EZdenki/nrf-repeater/nrf-base-bb.jpg

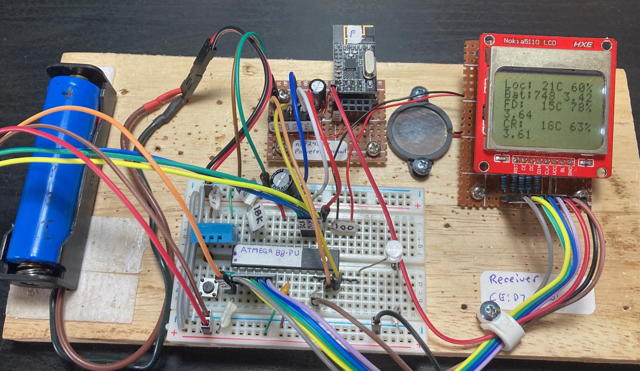
nrf-base-bb.jpg
