EZdenki/nrf-repeater/nrf-remote-sensor-a.jpg

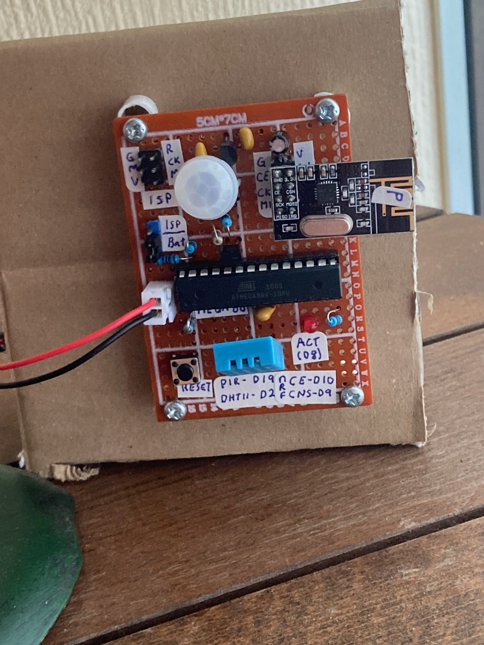
nrf-remote-sensor-a.jpg
