EZdenki/nrf-repeater/LCD-text-grid.docx

Lo 24C 58% B

CR 25C 51% *

FD 32C 28% 3

G1 22C 50% B

G2 28C 28%

R* CR1 FD1

Lo 3.45 V

CR 4.02 V 3

FD 2.08 V B

R* 3.54 V

Lo=Local

CR=Classroom

FD=Fr.Door

G1=Garden 1

G2=Garden 2
