EZdenki/nrf-repeater/moisture-sensor-voltage-follower.png

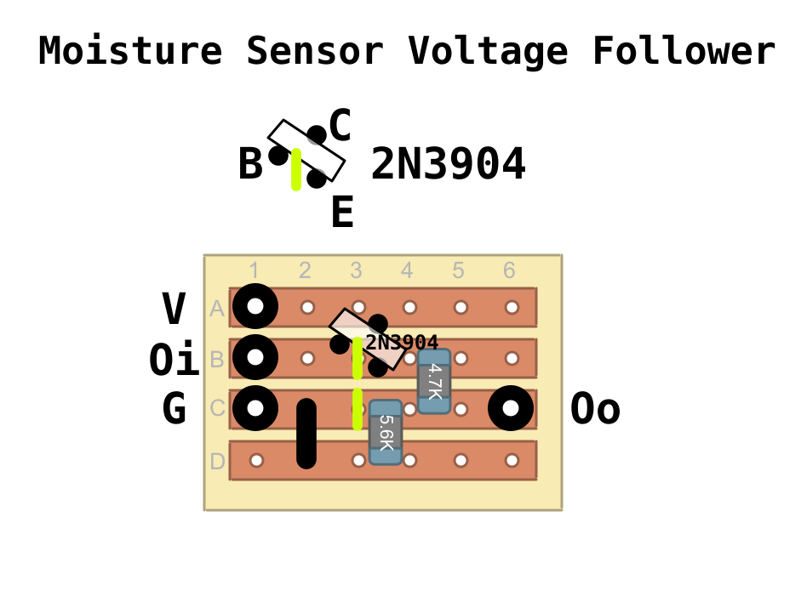
moisture-sensor-voltage-follower.png
