EZdenki/nrf-repeater/narf-remote-sensor-in-situ.jpg

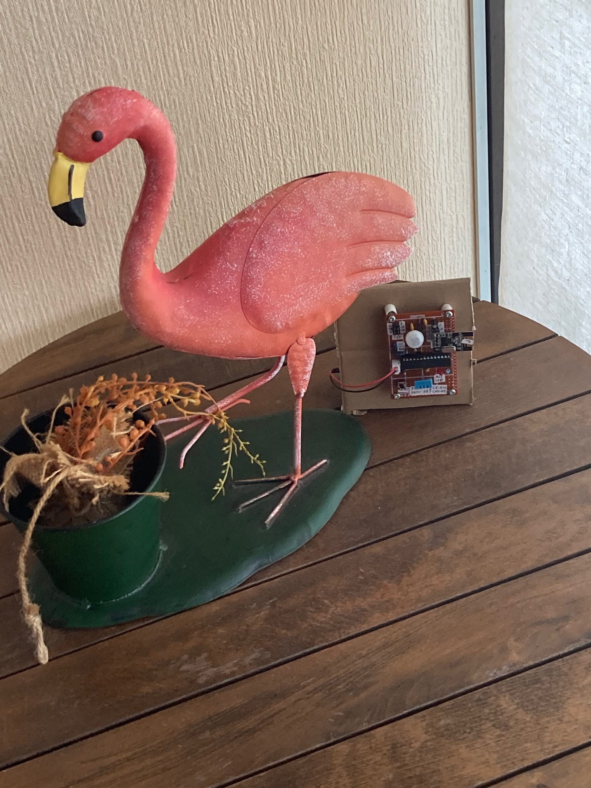
narf-remote-sensor-in-situ.jpg
