EZdenki/nrf-repeater/nrf-moisture-sensor-xmt-v1.1.png

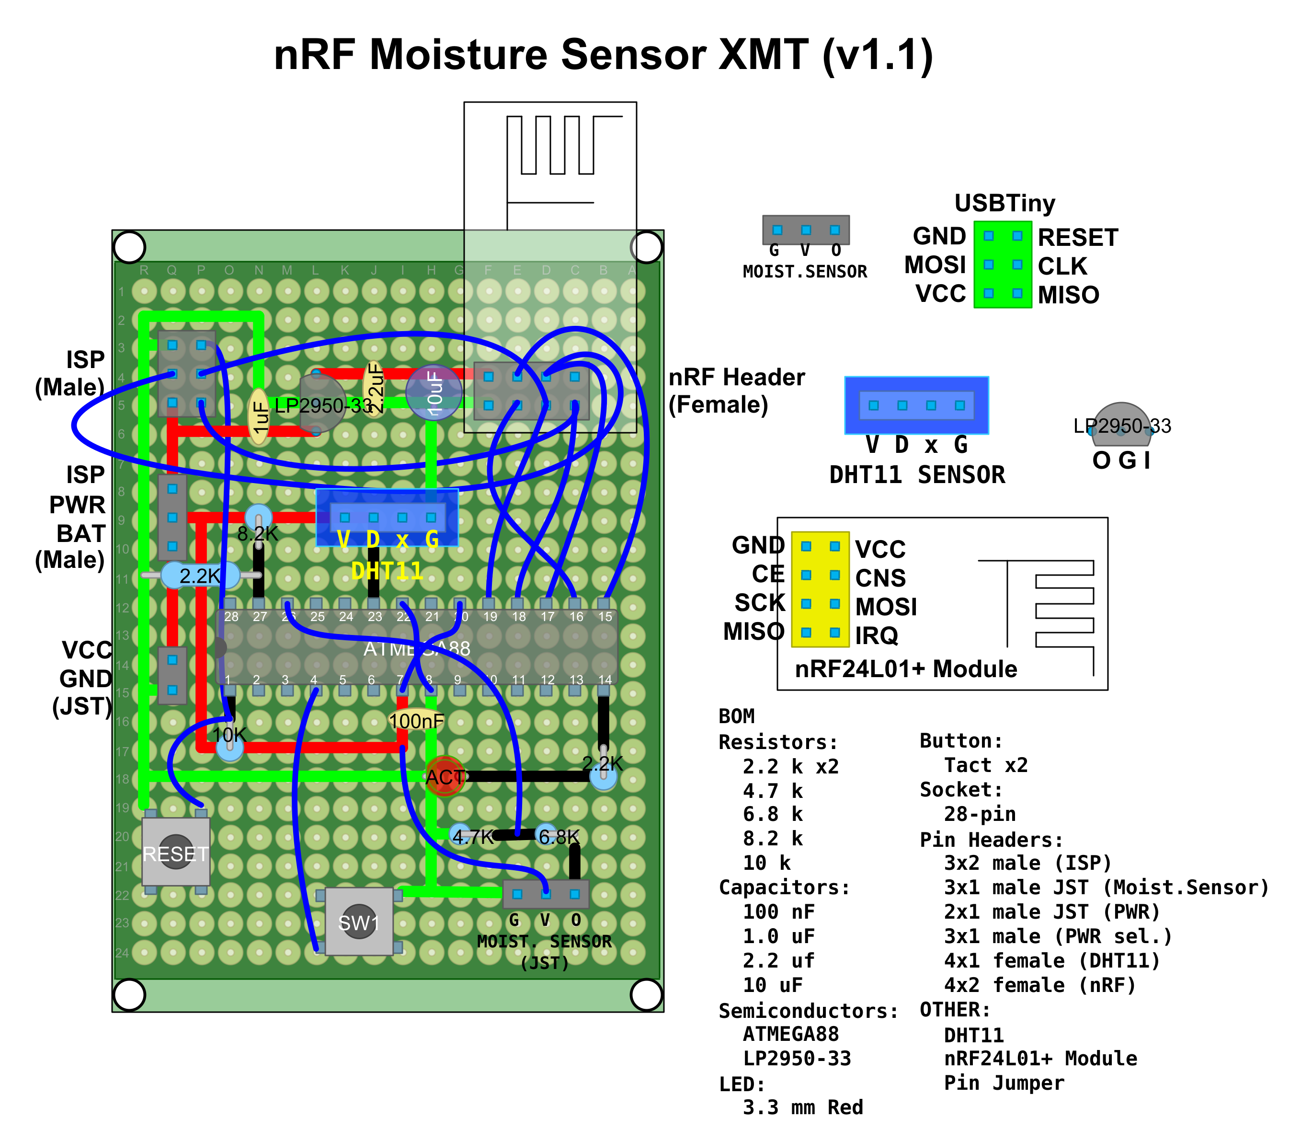
nrf-moisture-sensor-xmt-v1.1.png
