EZdenki/nrf-repeater/nrf-PIR-sensor-xmt-v1.3.png

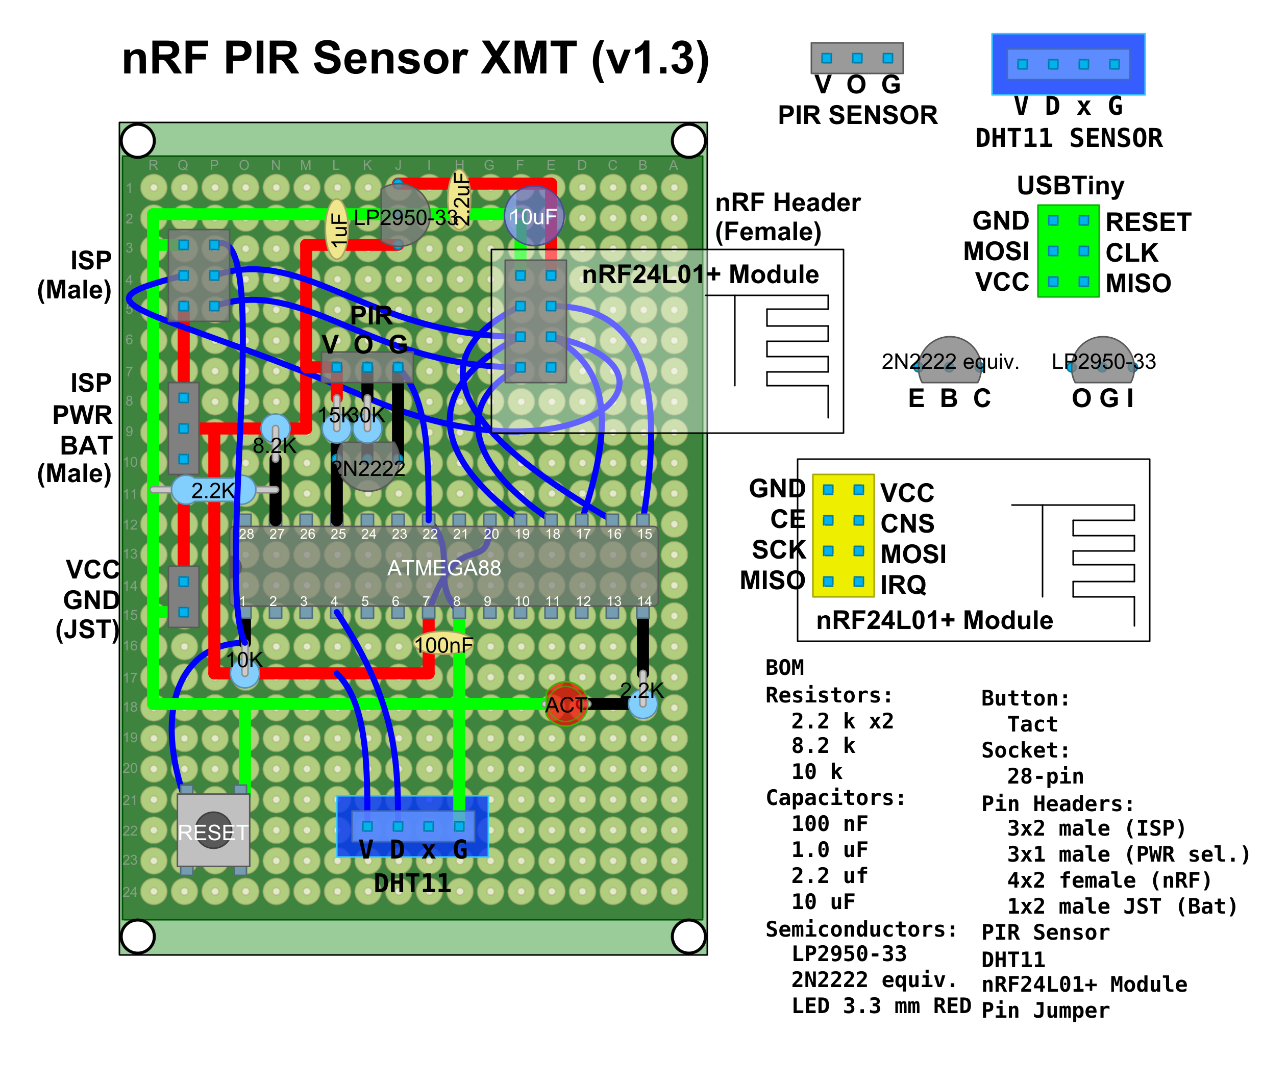
nrf-PIR-sensor-xmt-v1.3.png
