EZdenki/nrf-repeater/nrf-receiver-v1.1.png

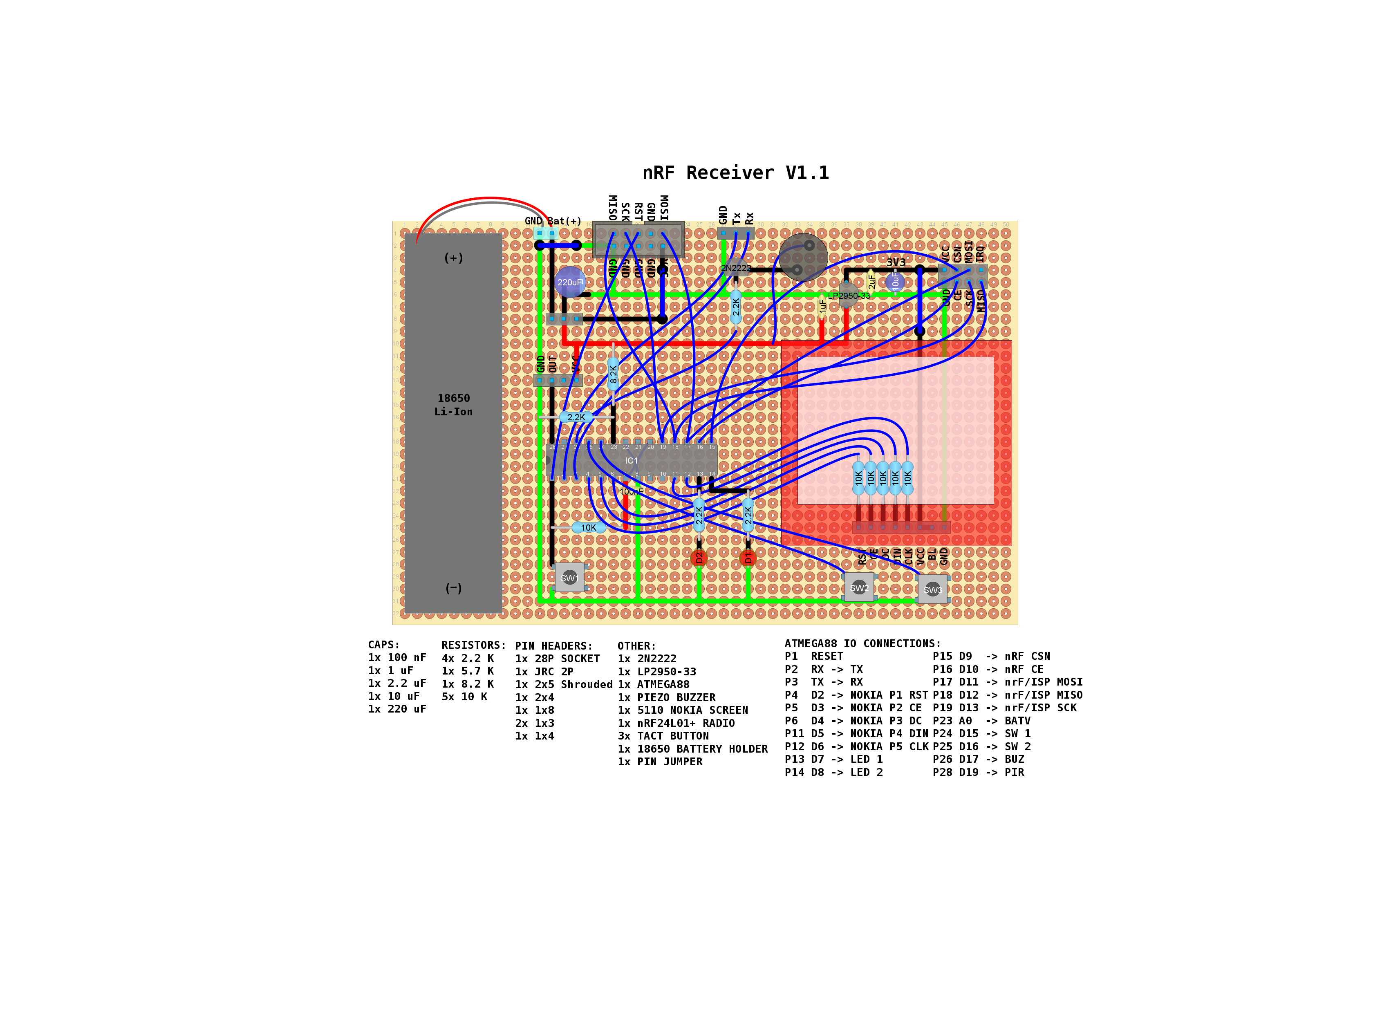
nrf-receiver-v1.1.png
