EZdenki/nrf-repeater/nrf-receiver-v1.2.png

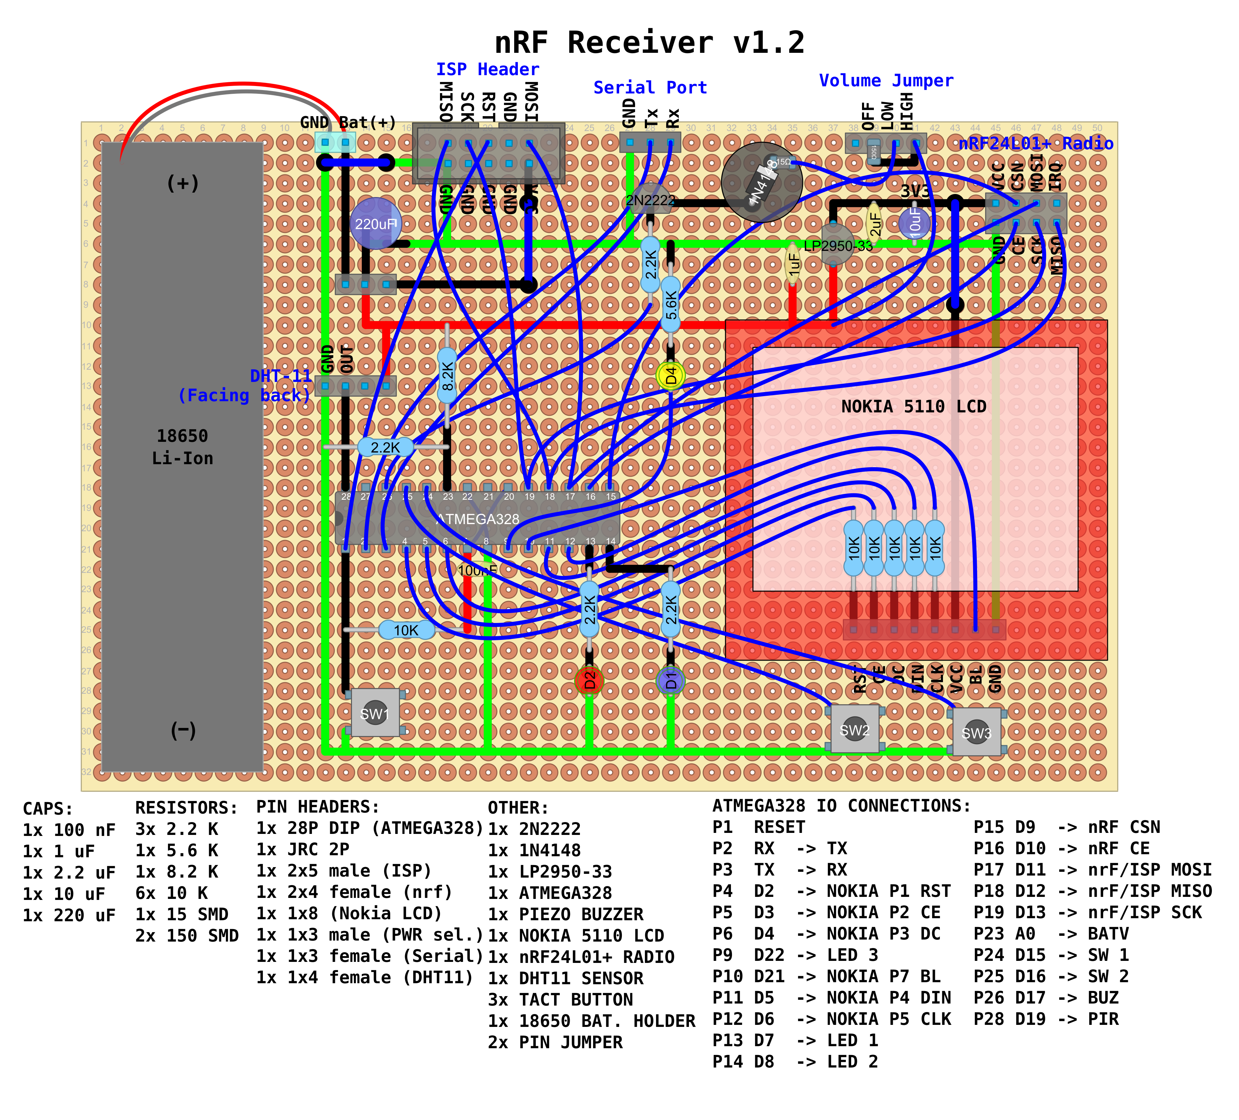
nrf-receiver-v1.2.png
