EZdenki/nrf-repeater/nrf-repeater-v1.1.png

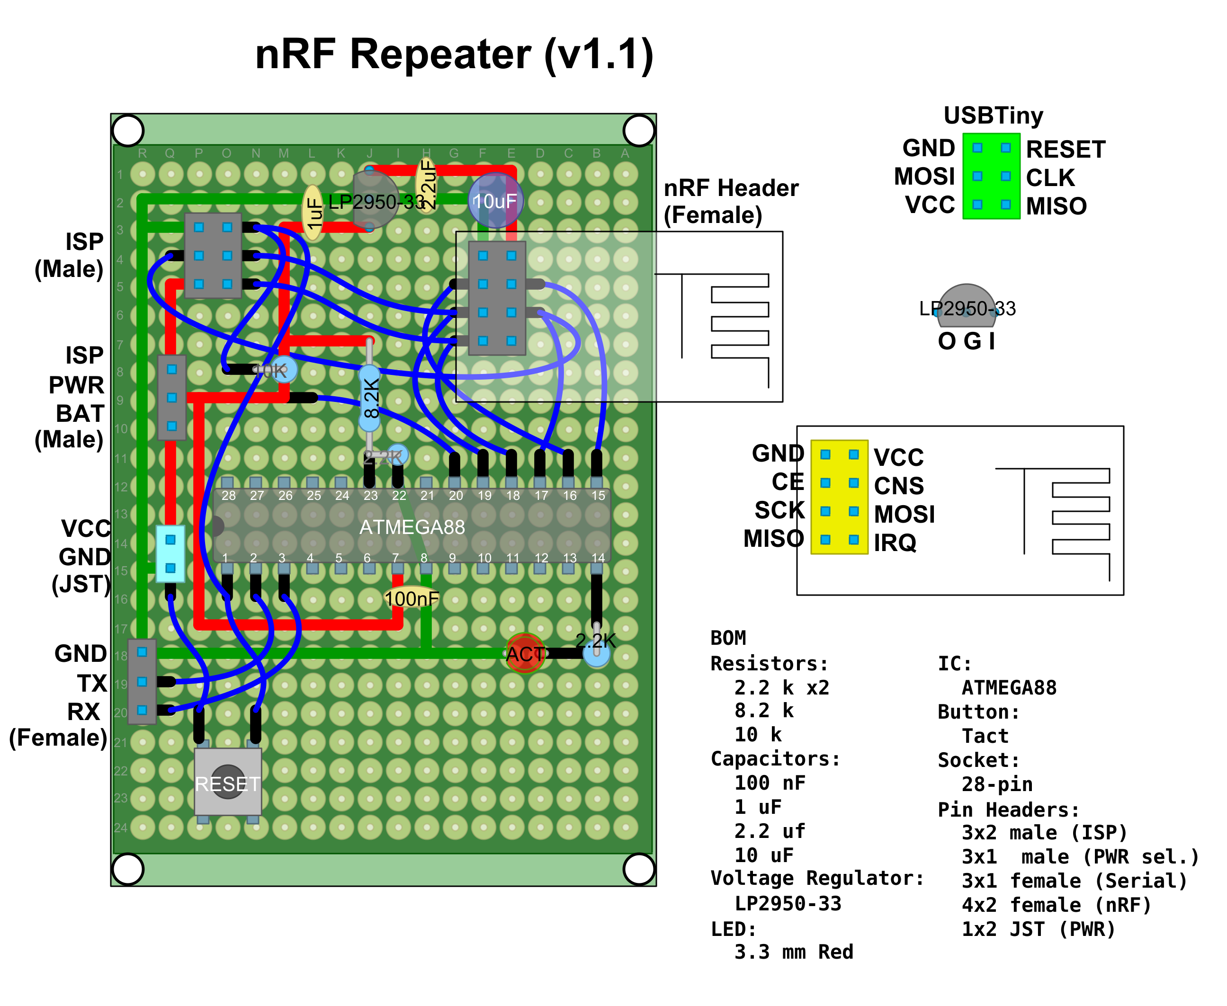
nrf-repeater-v1.1.png
