EZdenki/nrf-repeater/nrf-repeater.jpg

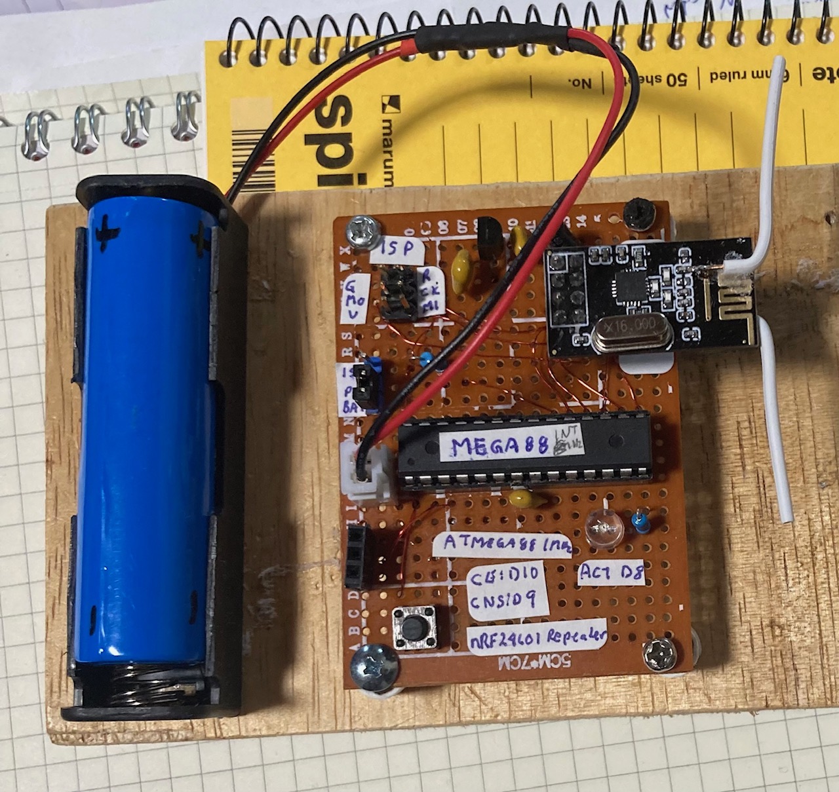
nrf-repeater.jpg
