EZdenki/nrf-repeater/Pics/nRF-Receiver-2.1-pic.jpg

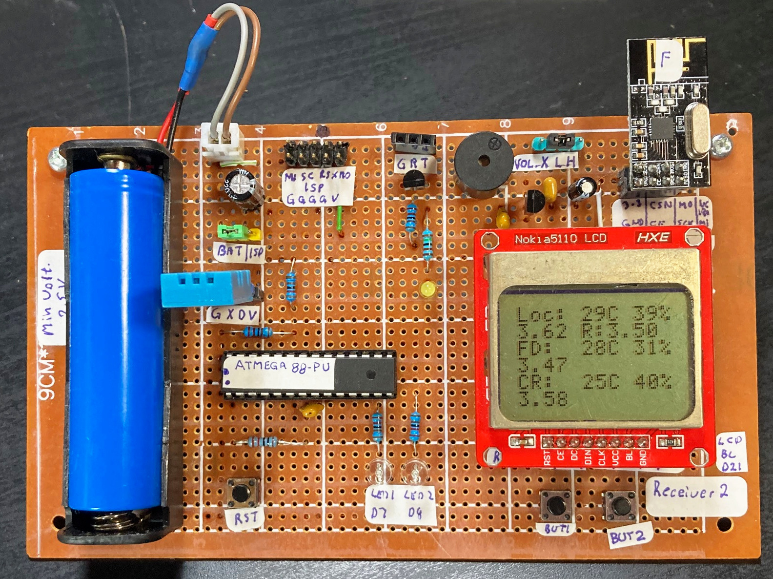
Pics/nRF-Receiver-2.1-pic.jpg
