EZdenki/nrf-repeater/sump/nrf-moisture-sensor-xmt-v0.9.png

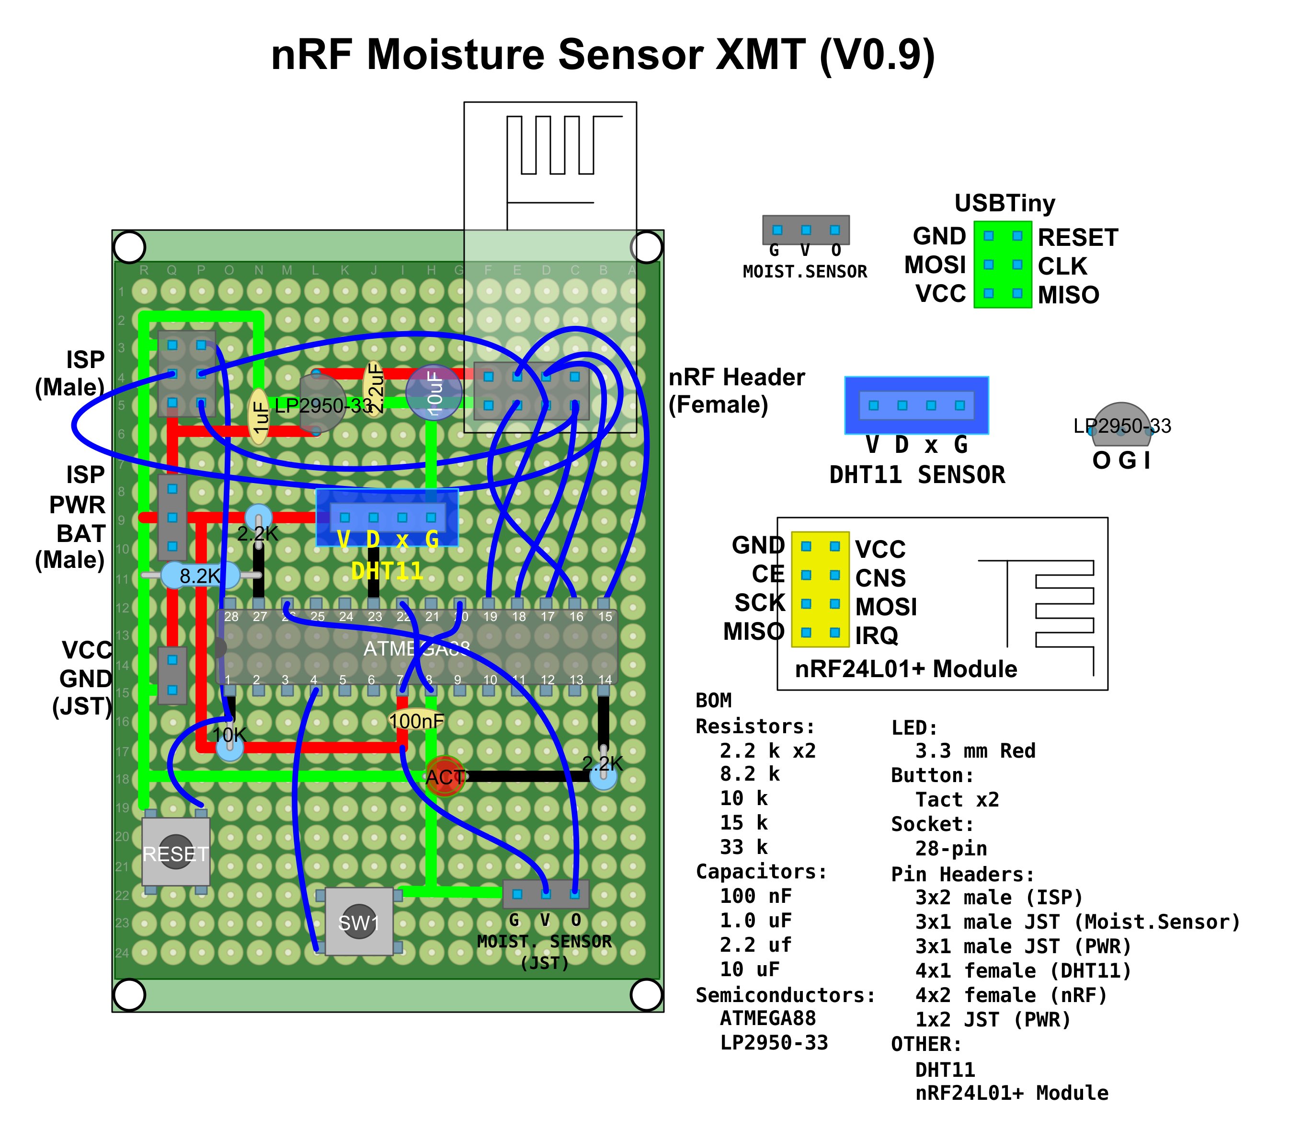
sump/nrf-moisture-sensor-xmt-v0.9.png
