EZdenki/nrf-repeater/sump/nrf-repeater-v1.3.png

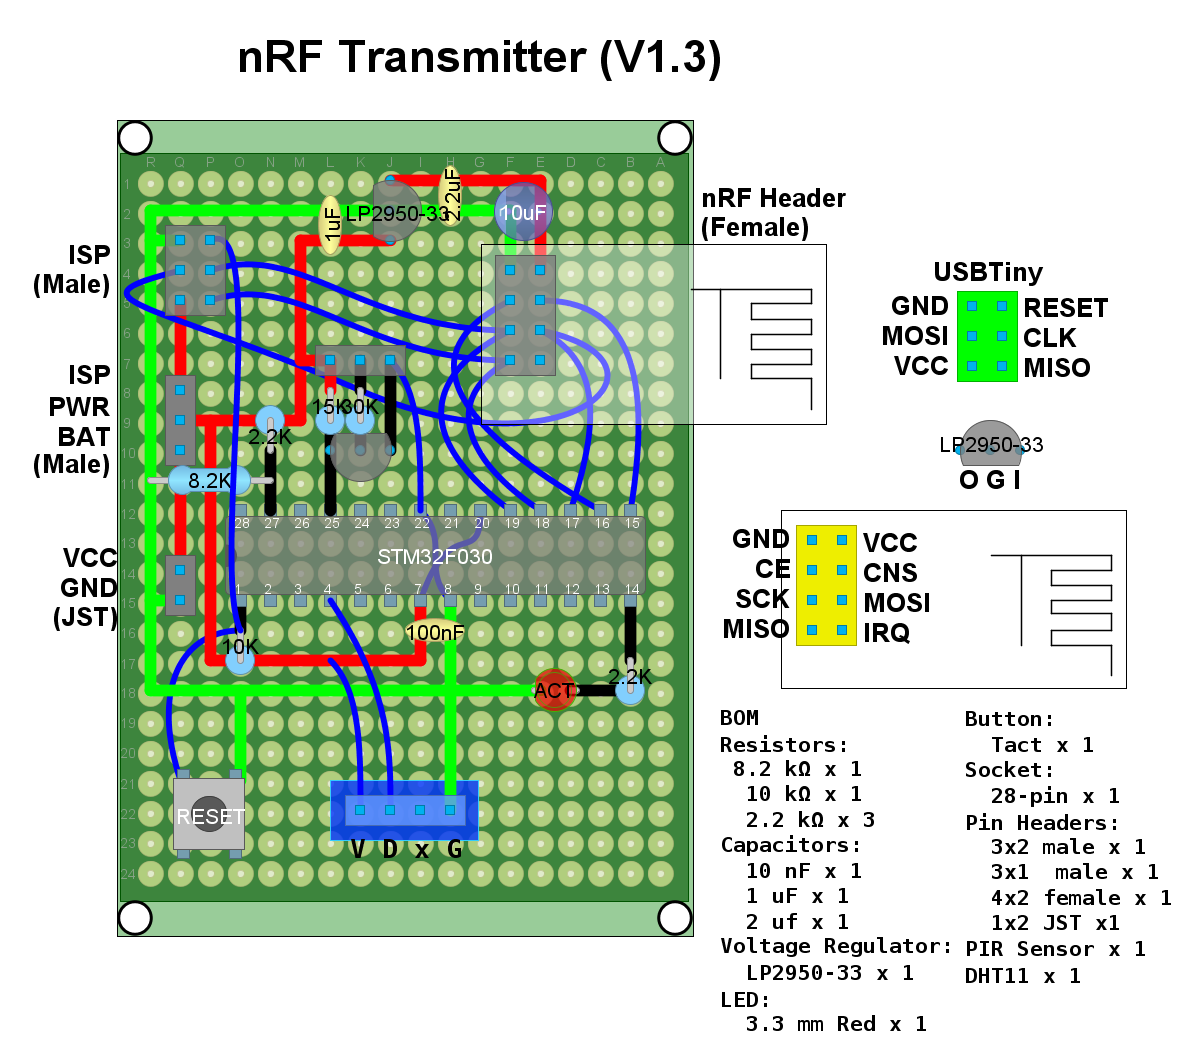
sump/nrf-repeater-v1.3.png
