EZdenki/nrf-repeater/sump/nrf-transmitterr-v1.2.png

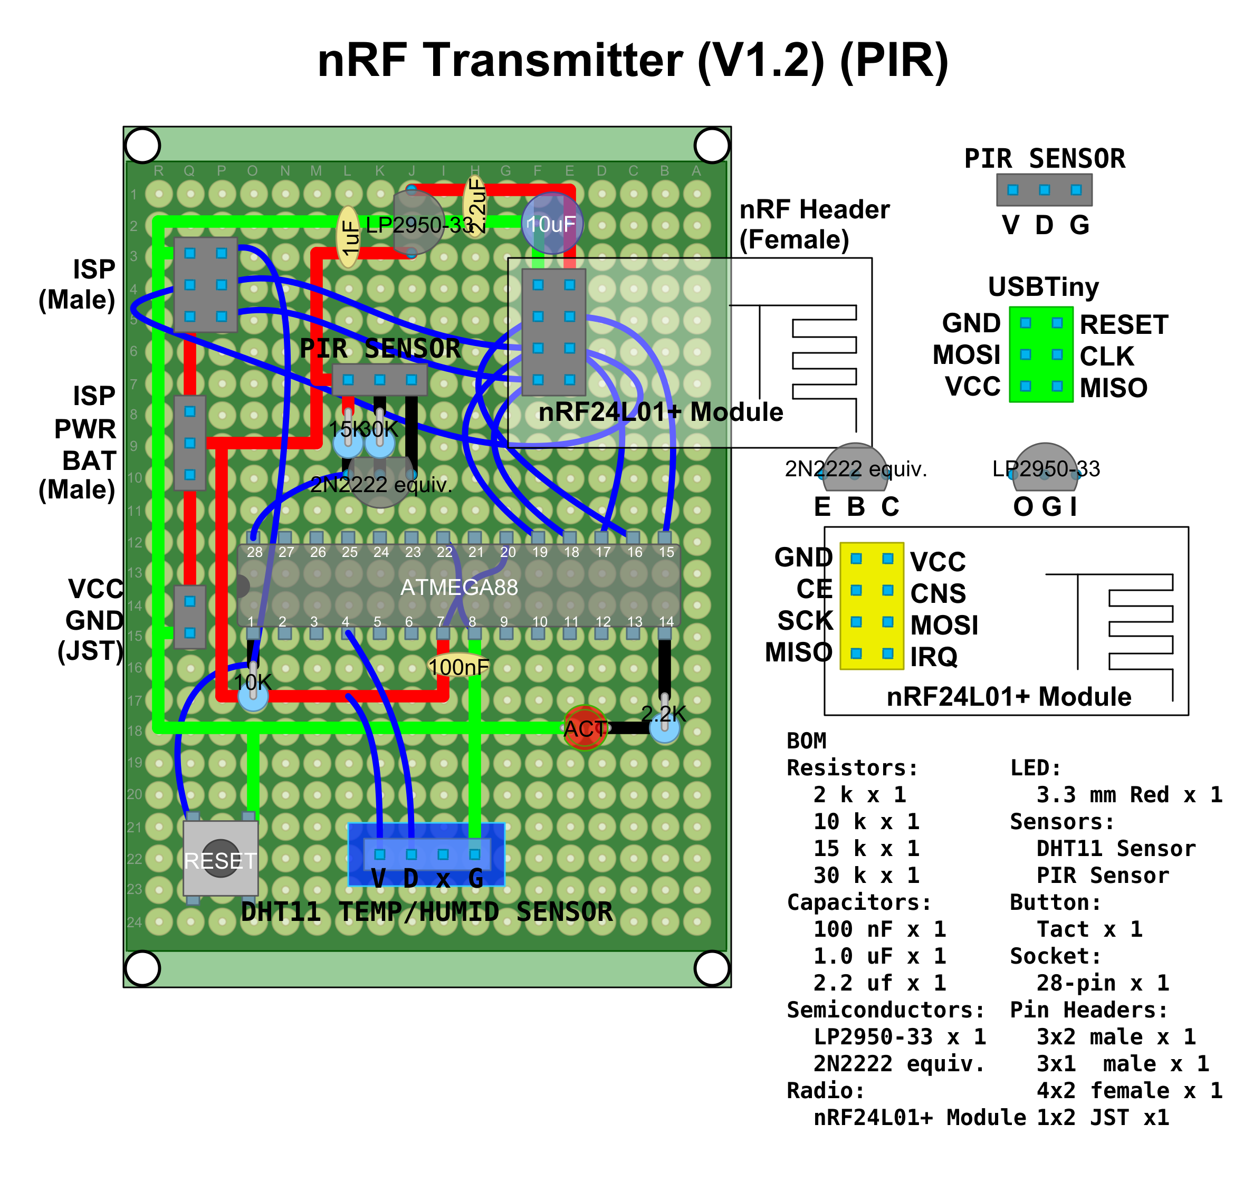
sump/nrf-transmitterr-v1.2.png
