EZdenki/nrf-repeater/nrf-moisture-sensor-xmt-v1.1.pdf

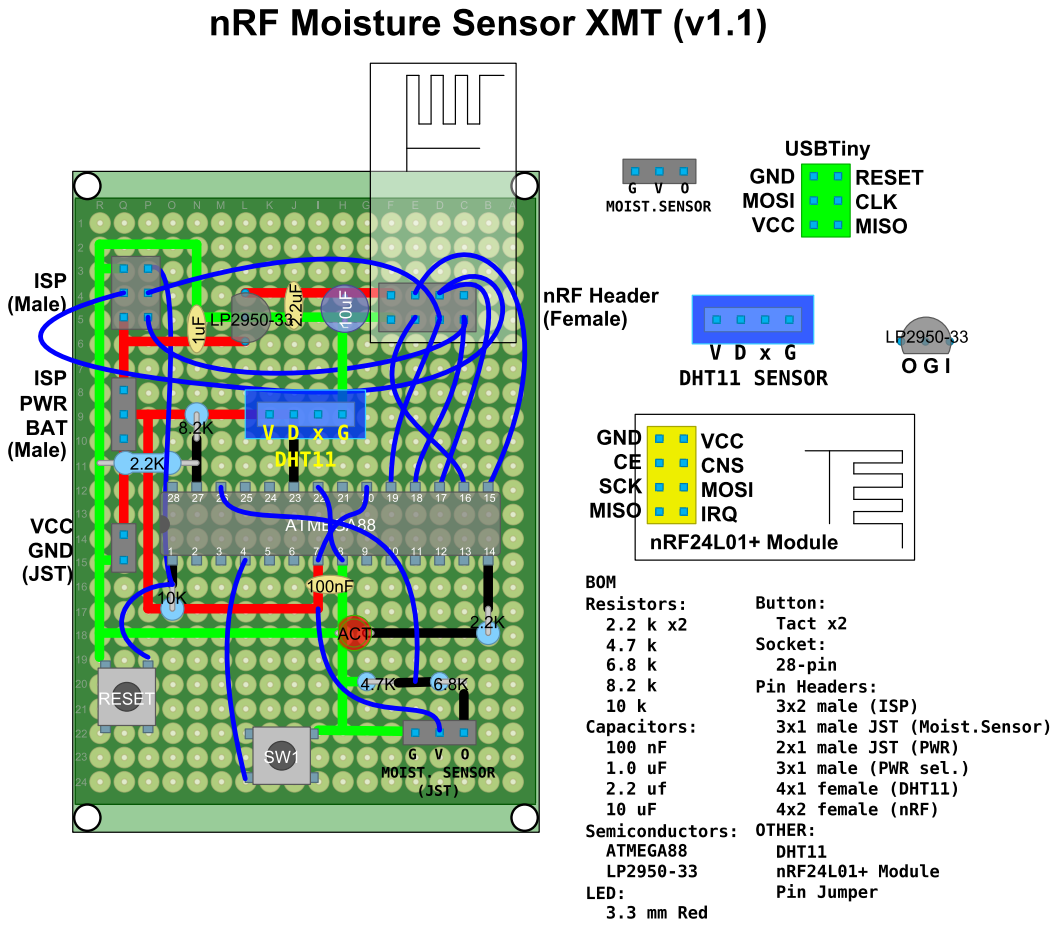
[picture p15: page 1]
