EZdenki/nrf-repeater/nrf-PIR-sensor-xmt-v1.3.pdf

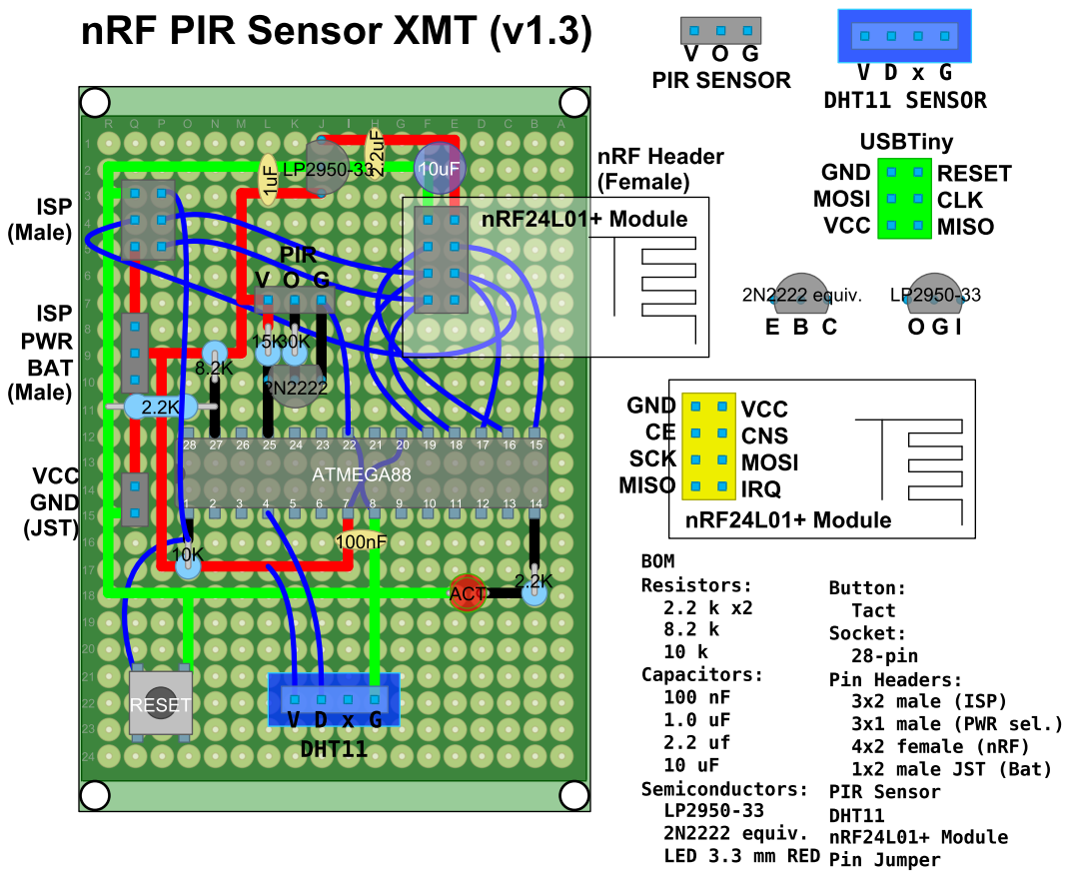
[picture p16: page 1]
