EZdenki/nrf-repeater/nrf-receiver-v1.2.pdf

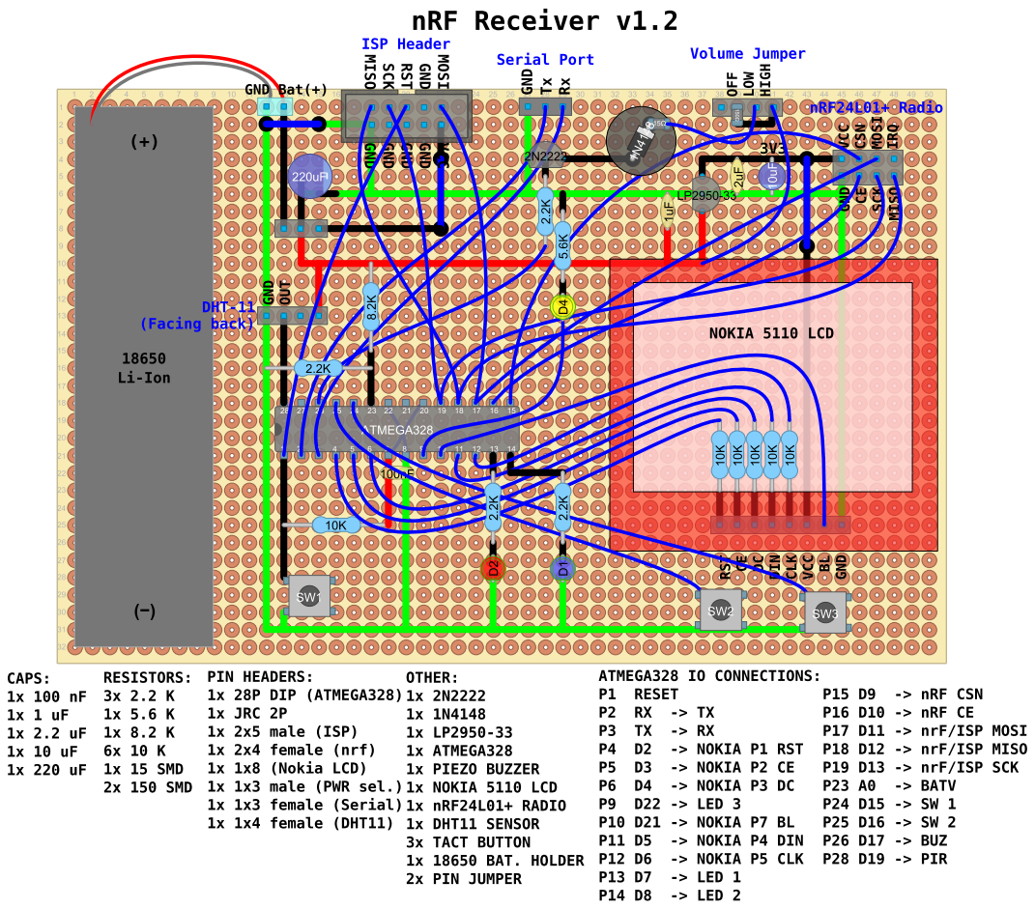
[picture p17: page 1]
