EZdenki/nrf-repeater/nrf-repeater-v1.1.pdf

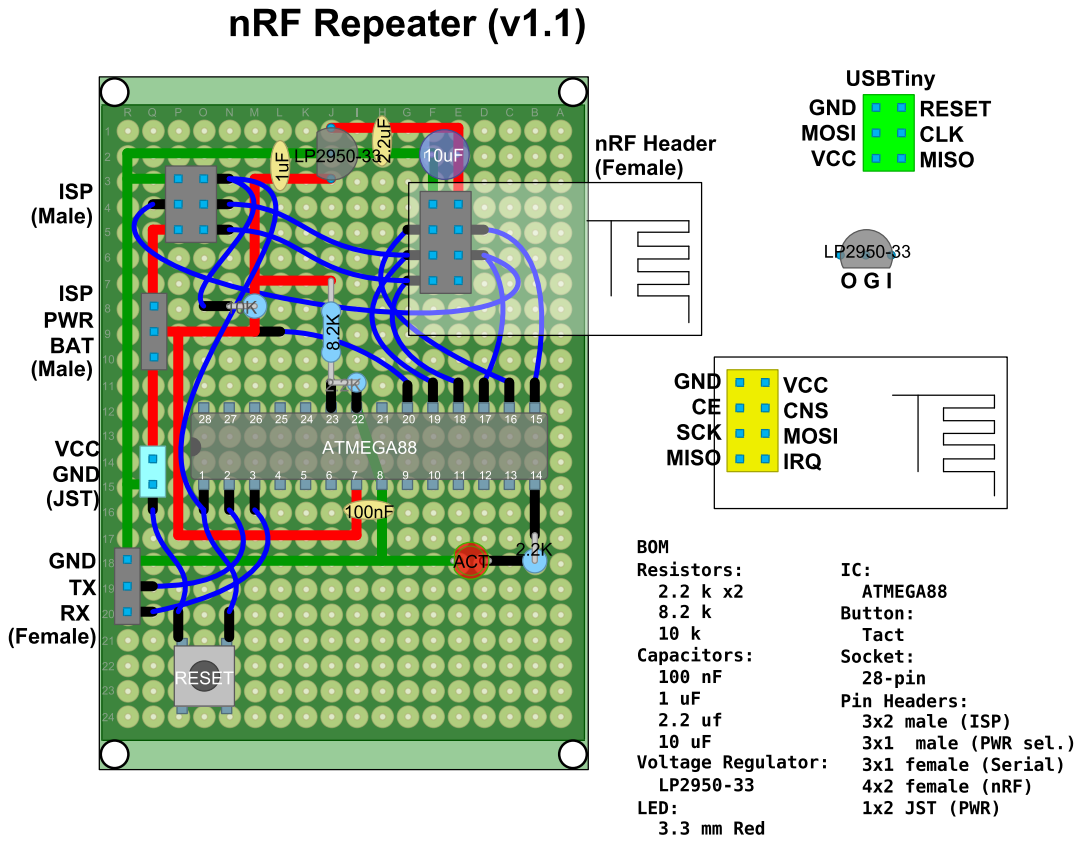
[picture p18: page 1]
