EZdenki/nrf-repeater/moisture-sensor-voltage-follower.pdf

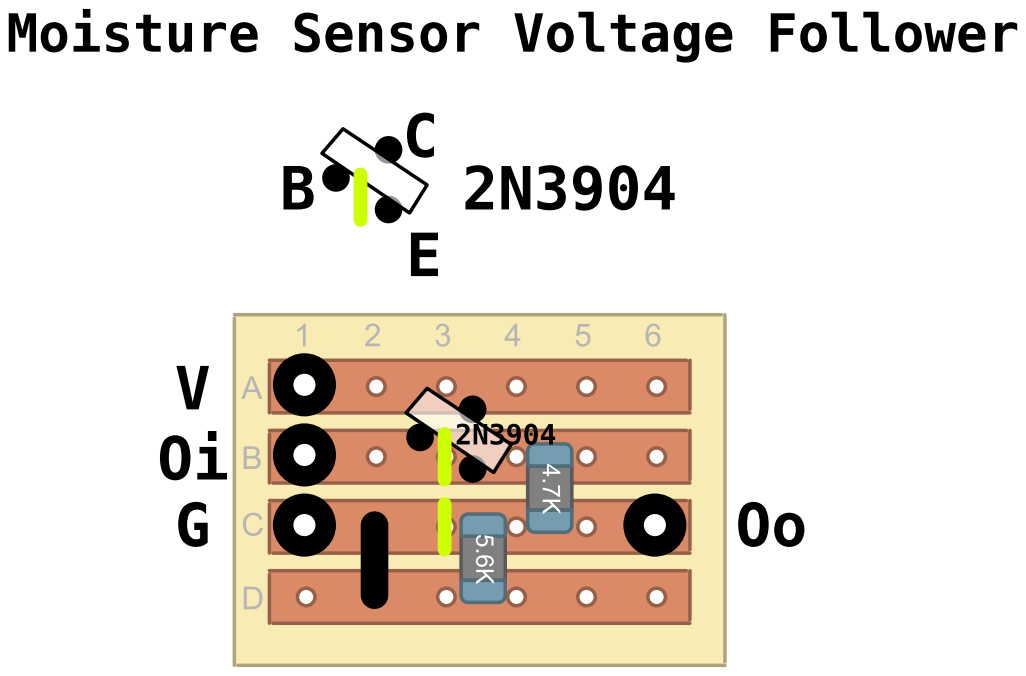
[picture p19: page 1]
