EZdenki/nrf-repeater/nrf-repeater-perfboard.pdf

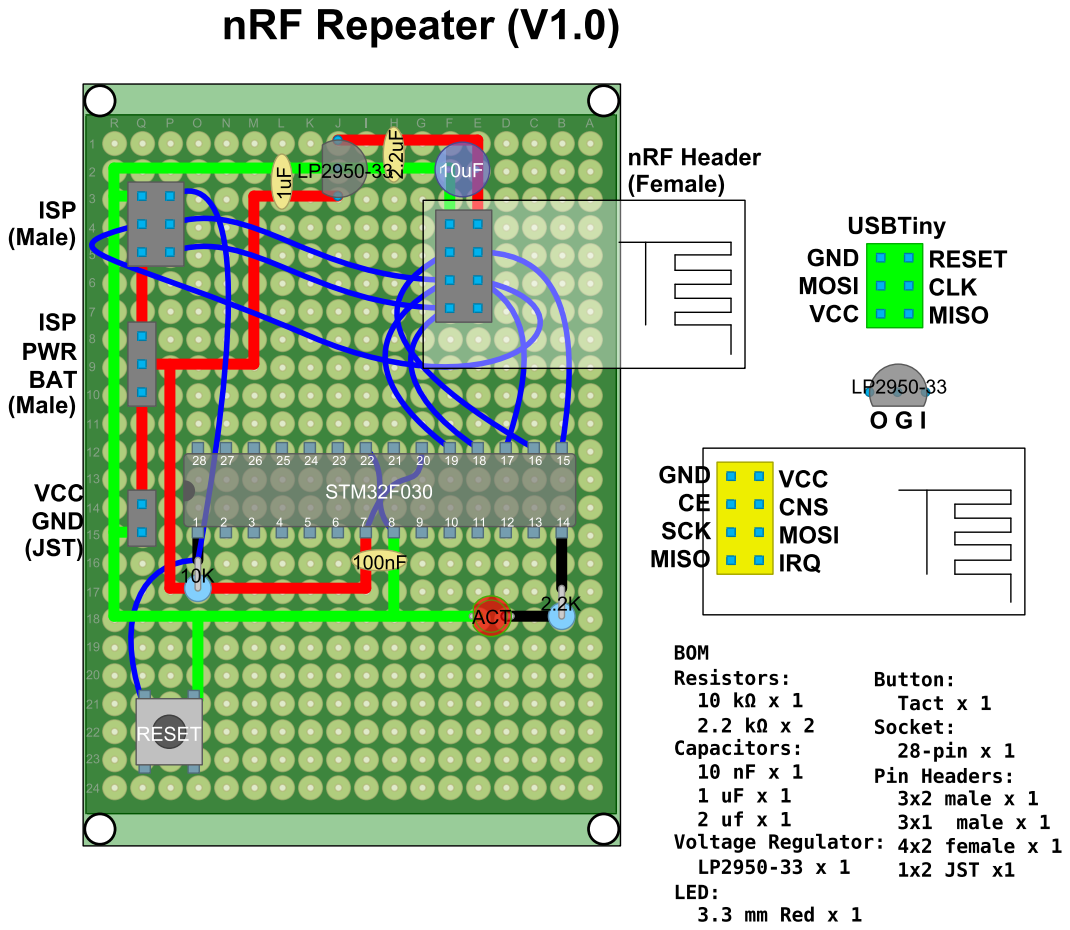
[picture p20: page 1]
