EZdenki/nrf-repeater/sump/nrf-moisture-sensor-xmt-v1.0.pdf

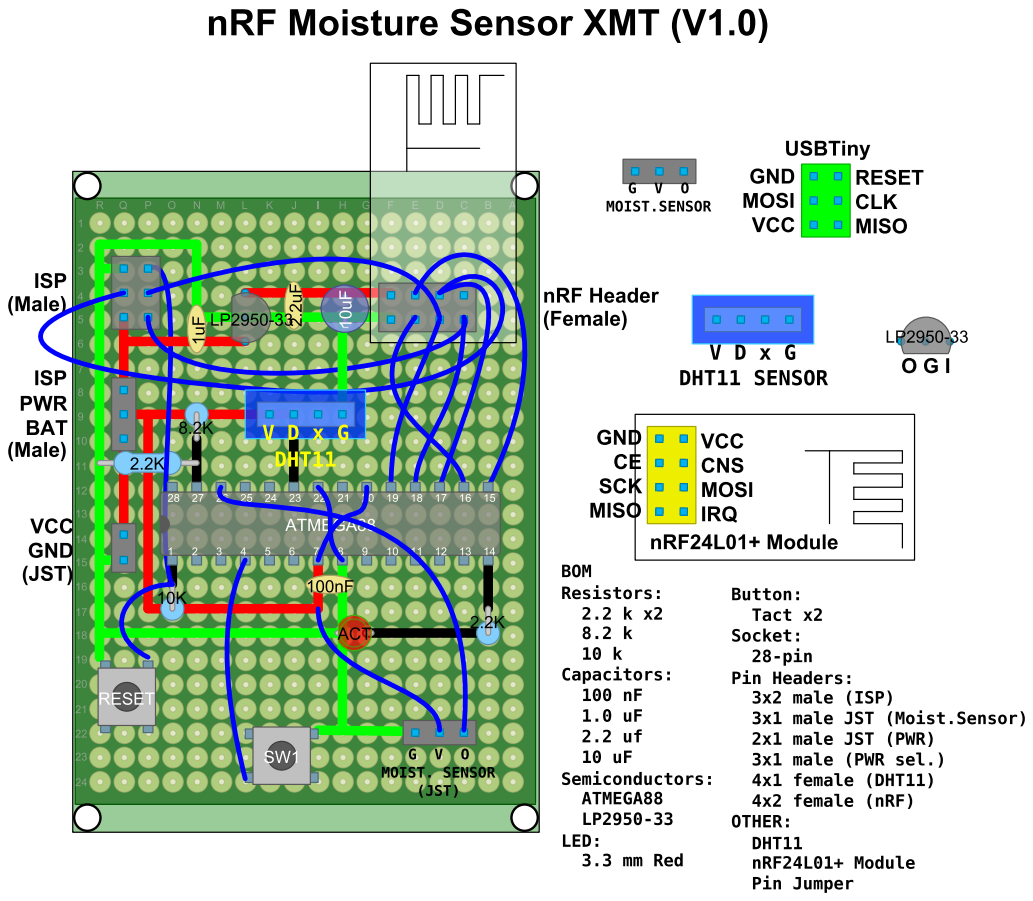
[picture p21: page 1]
