EZdenki/nrf-repeater/sump/nrf-transmitterr-v1.2.pdf

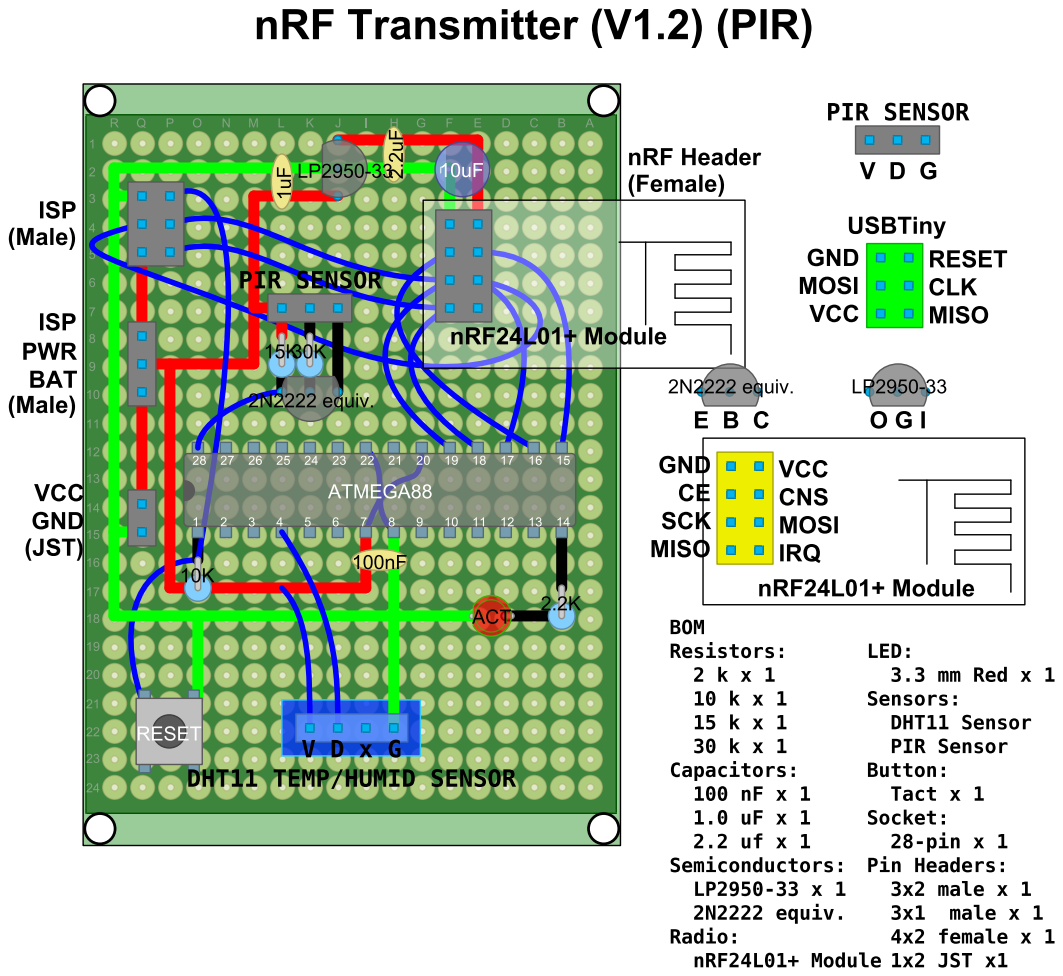
[picture p22: page 1]
