EZdenki/nrf-repeater/sump/nrf-repeater-v3.pdf

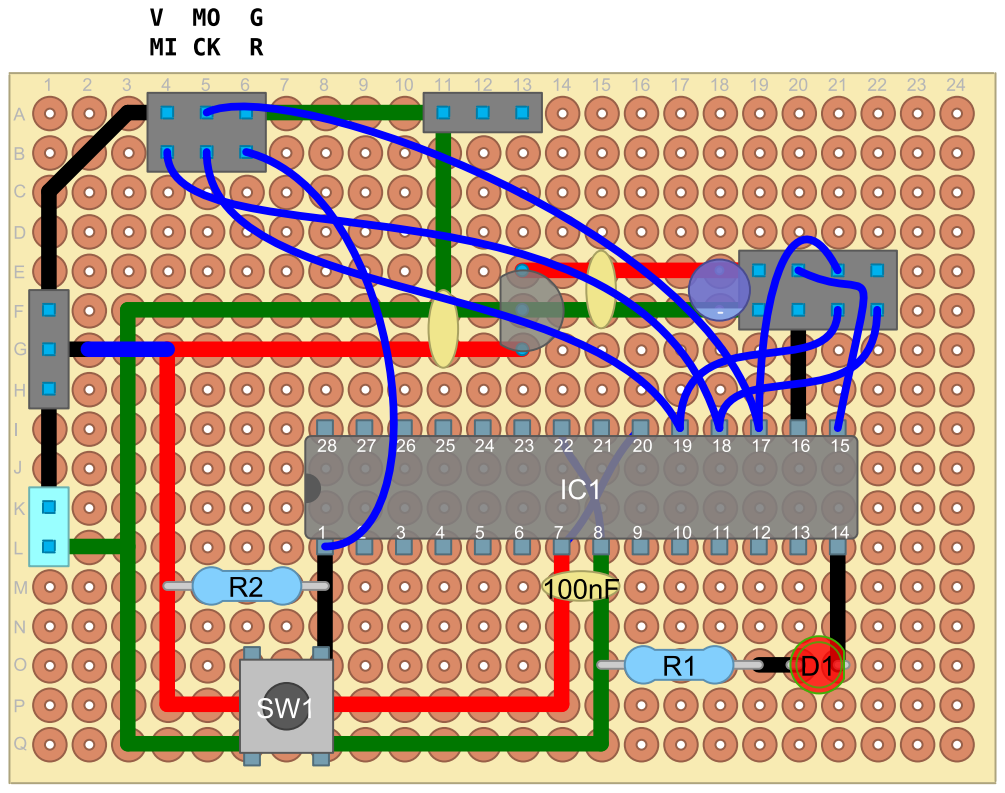
[picture p23: page 1]
