EZdenki/nrf-repeater/nrf-receiver-v1.1.pdf

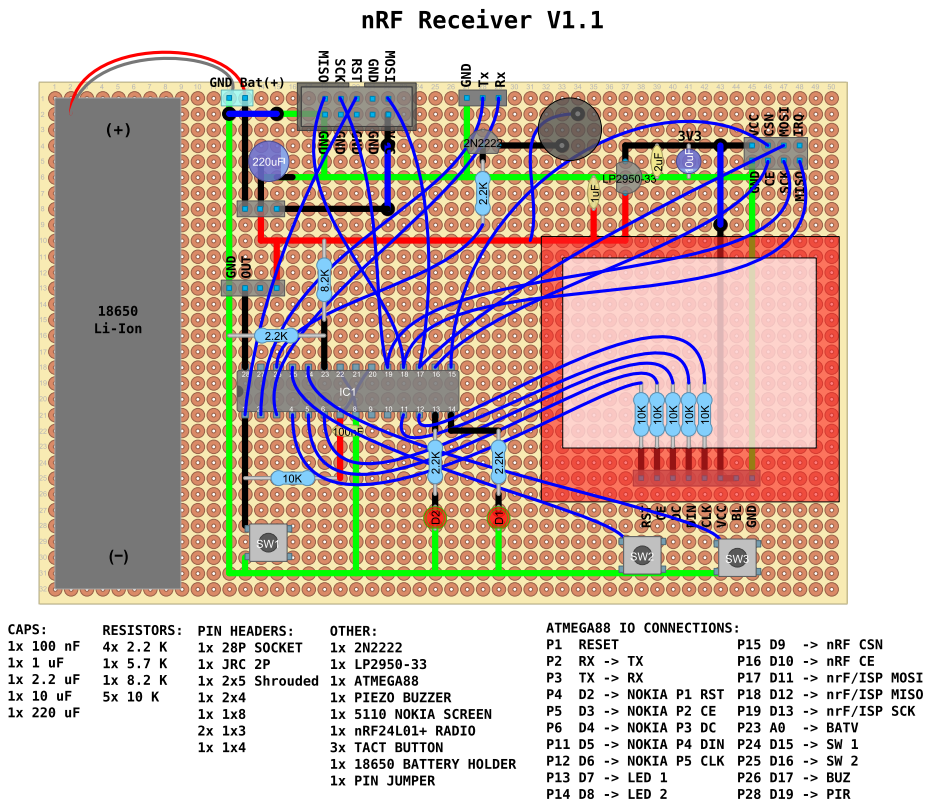
[picture p24: page 1]
