EZdenki/nrf-repeater/nrf-receiver-v1.pdf

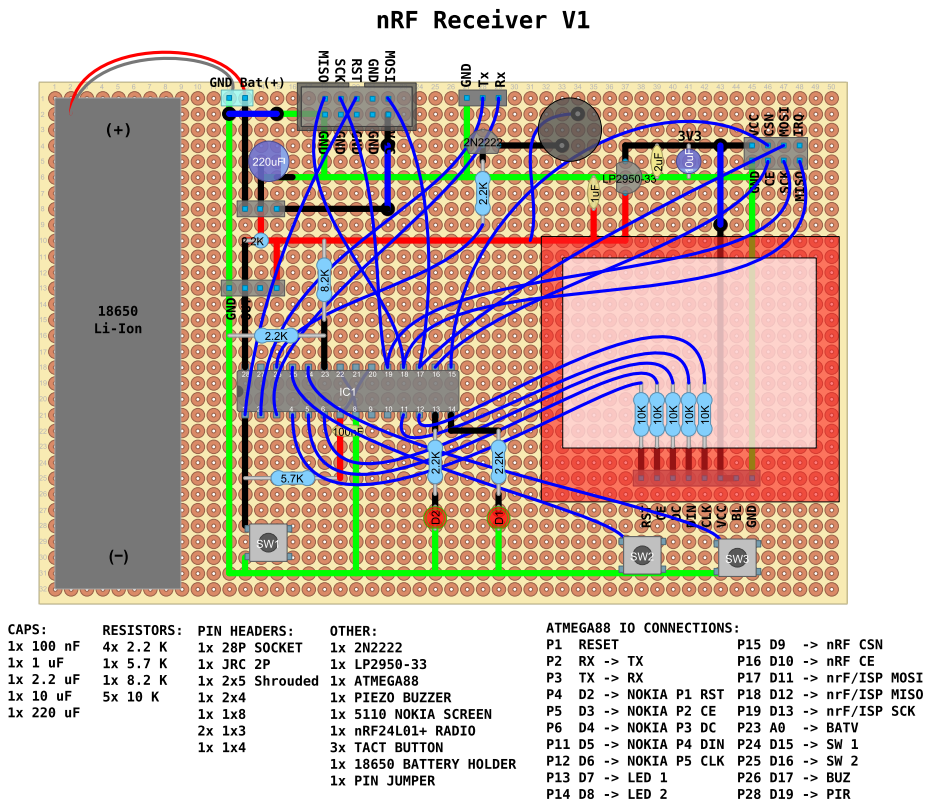
[picture p25: page 1]
