EZdenki/nrf-repeater/sump/nrf-moisture-sensor-xmt-v0.9.pdf

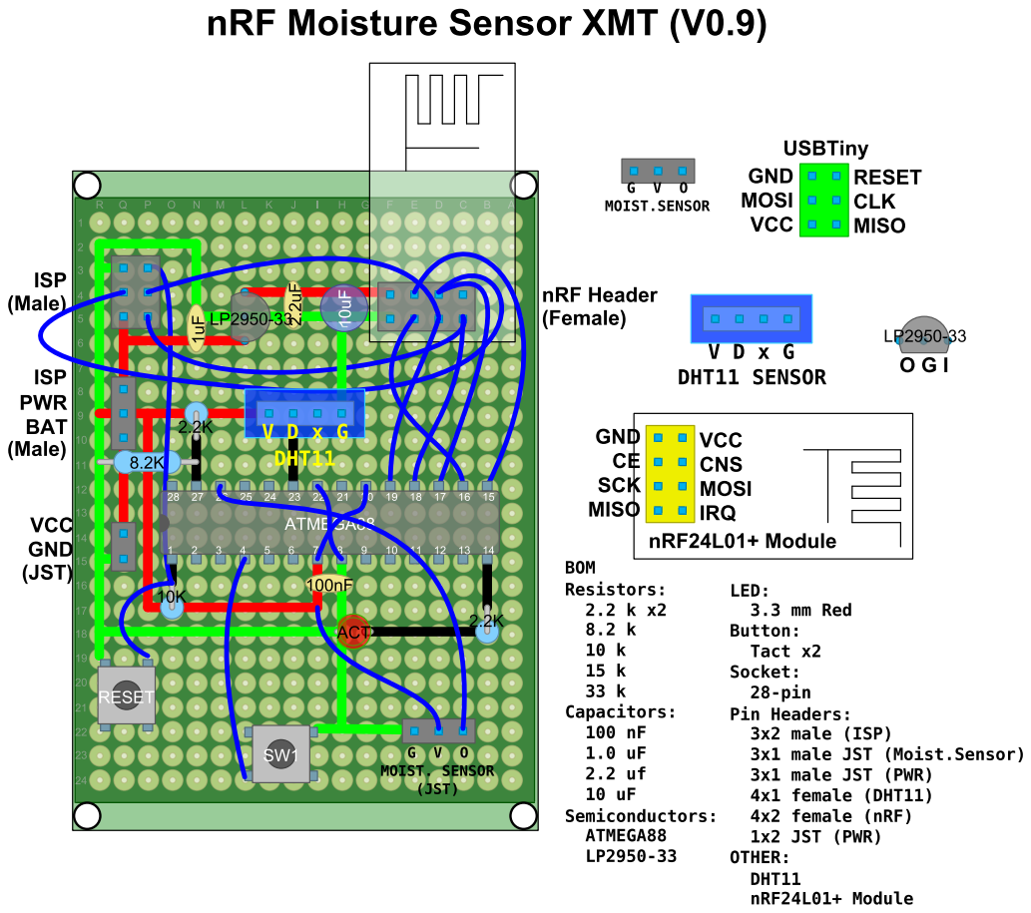
[picture p26: page 1]
