EZdenki/nrf-repeater/sump/nrf-repeater-v1.3.pdf

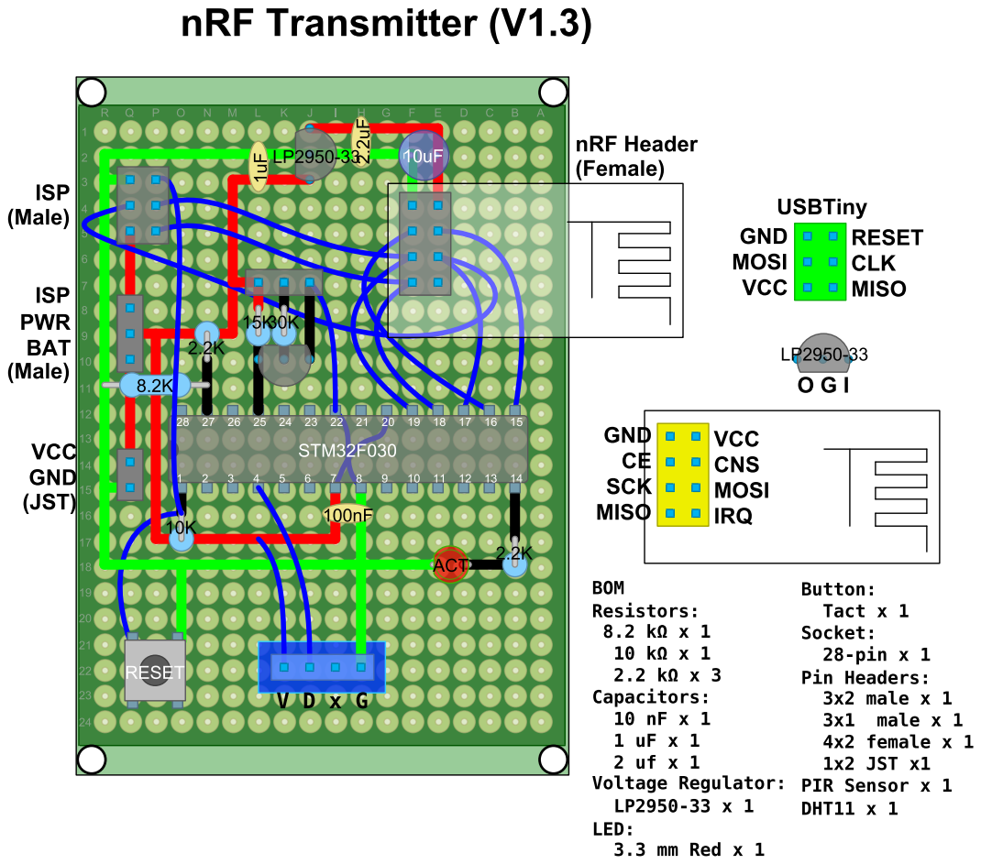
[picture p27: page 1]
