EZdenki/nrf-repeater/sump/nrf-transmitterr-v1.1.pdf

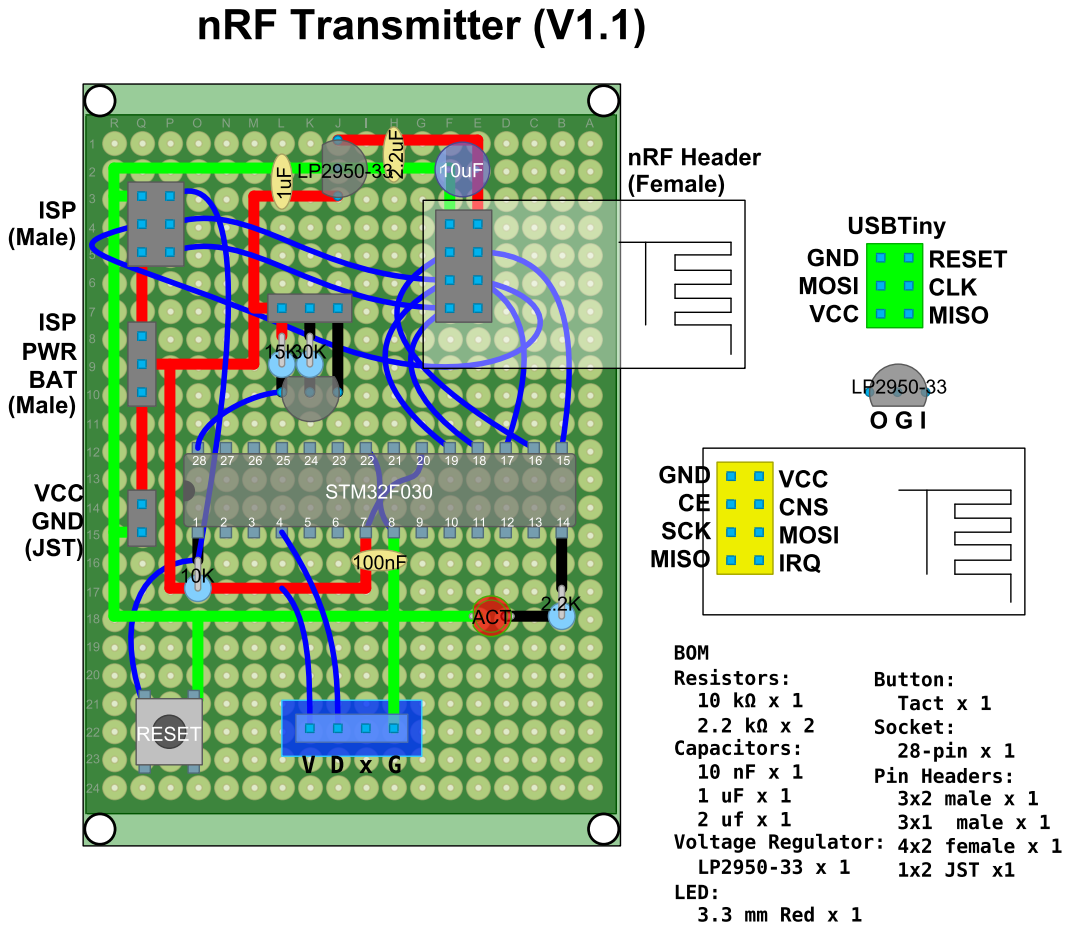
[picture p28: page 1]
