EZdenki/nrf-repeater/nrf-m88-repeater/nrf-m88-repeater.kicad_pcb

## KiCad design nrf-m88-repeater/nrf-m88-repeater.kicad_pcb (2024-08-17)

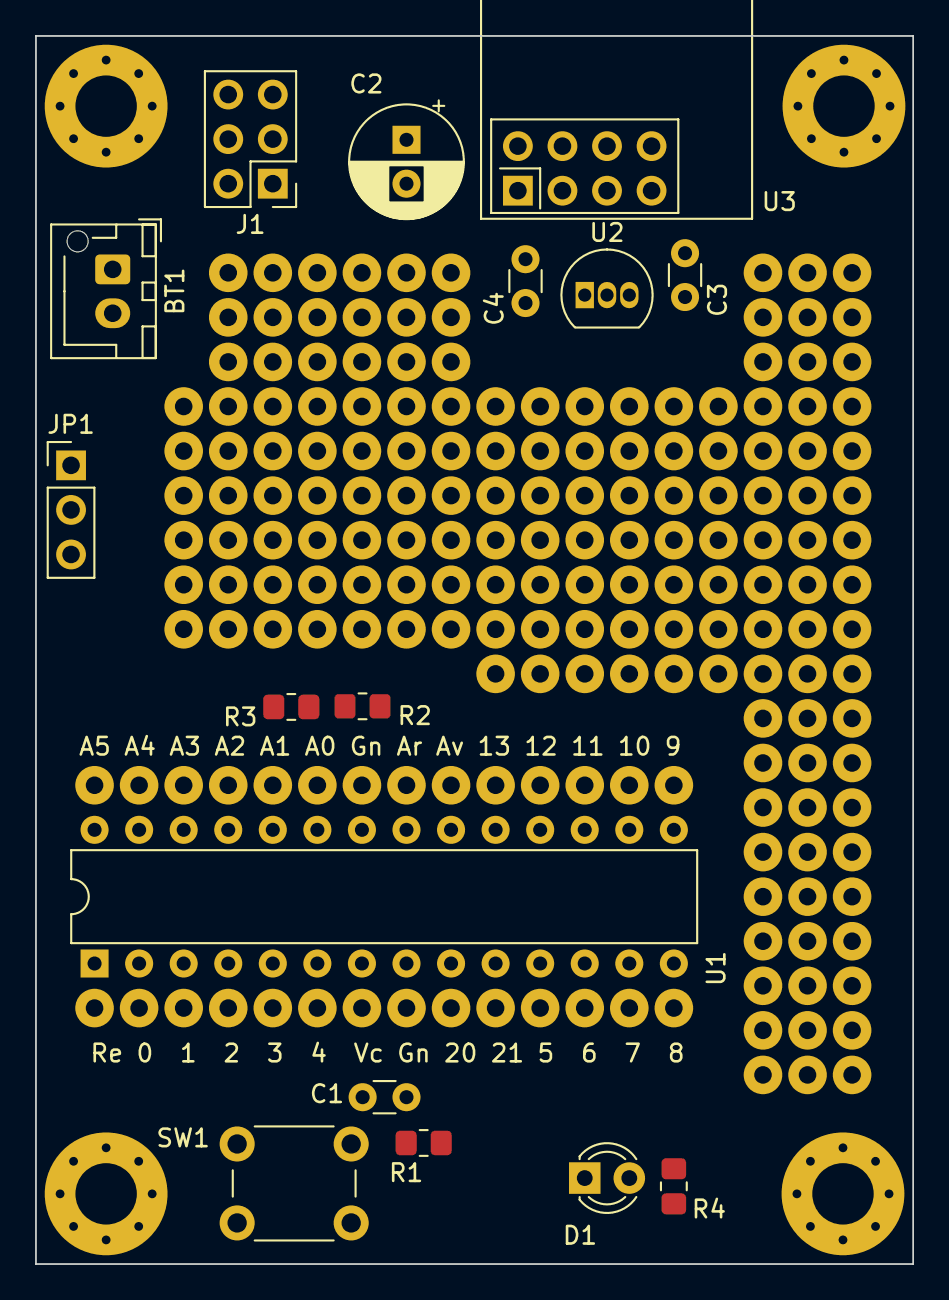
[picture p29: board nrf-m88-repeater.kicad_pcb from above]

Board: 2 copper layers, 50.0 x 70.0 mm, 20 parts (0 on the bottom side), 13 nets, no tracks yet.

Parts:
BT1: 18650 Battery Holder; JST_XH_B2B-XH-AM_1x02_P2.50mm_Vertical
C1: 100n; C_Disc_D3.0mm_W1.6mm_P2.50mm
C2: 10u; CP_Radial_D6.3mm_P2.50mm
C3: 1u; C_Disc_D3.0mm_W1.6mm_P2.50mm
C4: 2.2u; C_Disc_D3.0mm_W1.6mm_P2.50mm
D1: LED; LED_D3.0mm_FlatTop
H1, H2, H3, H4: MountingHole; MountingHole_3.5mm_Pad_Via
J1: Conn_02x03_Counter_Clockwise; PinHeader_2x03_P2.54mm_Vertical
JP1: PWR Sel.; PinHeader_1x03_P2.54mm_Vertical
R1: 10k; R_0805_2012Metric_Pad1.20x1.40mm_HandSolder
R2: 8.2k; R_0805_2012Metric_Pad1.20x1.40mm_HandSolder
R3: 2.2k; R_0805_2012Metric_Pad1.20x1.40mm_HandSolder
R4: 2k; R_0805_2012Metric_Pad1.20x1.40mm_HandSolder
SW1: RESET; SW_PUSH_6mm
U1: ATmega88; DIP-28_W7.62mm
U2: LP2950-3.3; TO-92_Inline
U3: NRF24L01_Breakout; nRF24L01_Breakout

Connections:
/3.3V: C2.1, C4.2, U2.1 (VO), U3.2 (VCC)
/D8ACT: R4.1, U1.14 (PB0)
/D11MOSI: J1.5, U1.17 (PB3), U3.6 (MOSI)
/D12MISO: J1.1, U1.18 (PB4), U3.7 (MISO)
/D13SCK: J1.2, U1.19 (PB5), U3.5 (SCK)
/D14A0: R2.2, R3.2, U1.23 (PC0)
/ISP_PWR: J1.6, JP1.3 (B)
/RESET: J1.3, SW1.1, U1.1 (~RESET/PC6)
/VCC: C1.1, C3.1, JP1.2 (C), R2.1, U1.7 (VCC), U1.20 (AVCC), U2.3 (VI)
GND: BT1.2 (-), C1.2, C2.2, C3.2, C4.1, D1.1 (K), J1.4, R1.1, R3.1, U1.8 (GND), U1.22 (GND), U2.2 (GND), U3.1 (GND)
unnamed: BT1.1 (+), JP1.1 (A)
unnamed: D1.2 (A), R4.2
unnamed: R1.2, SW1.2
