EZdenki/nrf-repeater/(commit log)

2024-05-26 Added V1.3 for Battery monitor
2024-05-29 Updated DHT11 wiring
2024-06-15 Added yellow warning LED
2024-06-15 Cleaned wiring
2024-06-29 Cleaned code, fixed bugs, updated project header file
    [nrf_repeater_project_receiver-2.ino, nrf_repeater_project_repeater.ino, nrf_repeater_project_transmitter-HC-SR04.ino, nrf_repeater_project_transmitter-s2.ino]
2024-07-01 Updated PIR transmitter, added moisture sensor transmitter
2024-07-02 Fixed battery-monitor voltage divider and other minor bugs.
2024-07-03 Added voltage divider to moisture sensor module. Calibrated moisture sensor battery voltage ADC.
2024-07-03 Added Moisture Sensor Voltage Follower PCB
2024-07-09 Updated DIY files to match actual PCBs
2024-08-17 Updated Generic KiCad Model
    [nrf-m88-repeater-w-bus.kicad_sch, nrf-m88-repeater.kicad_pcb]
